adithya-chakravarthi-02/VENOTRACE_IoT_Dashboard/docs/images/dashboard_preview.jpg

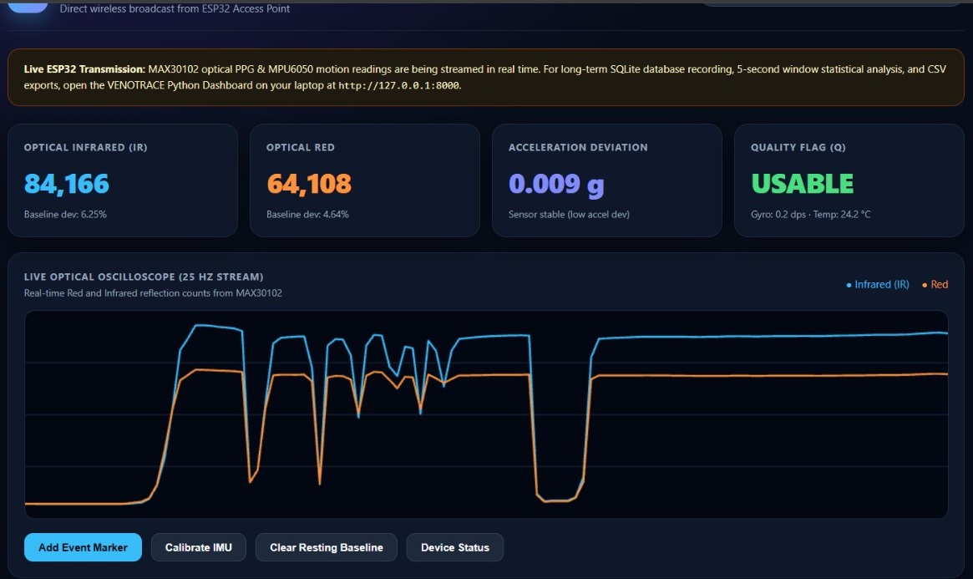
docs/images/dashboard_preview.jpg
