adithya-chakravarthi-02/VENOTRACE_IoT_Dashboard/docs/images/hardware_prototype.jpg

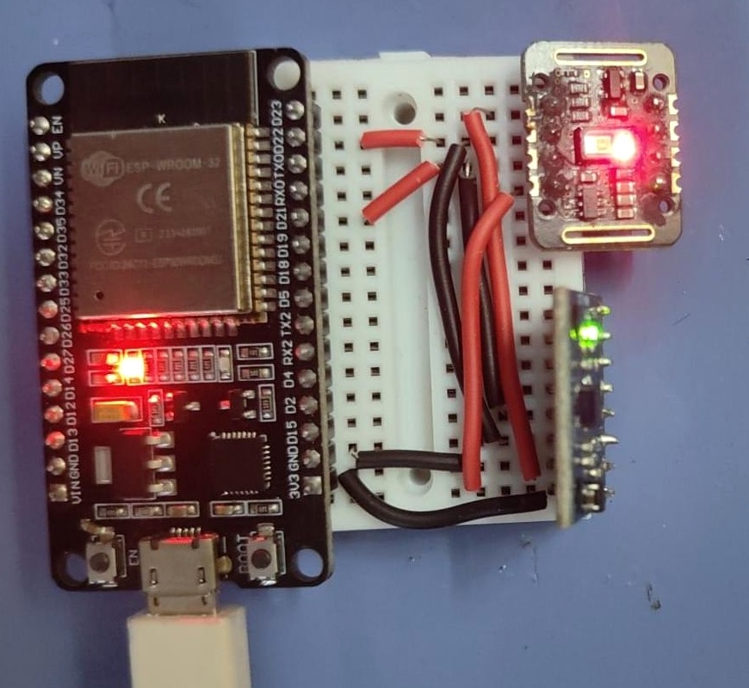
docs/images/hardware_prototype.jpg
