adithya-chakravarthi-02/VENOTRACE_IoT_Dashboard/docs/images/overview_block_diagram.png

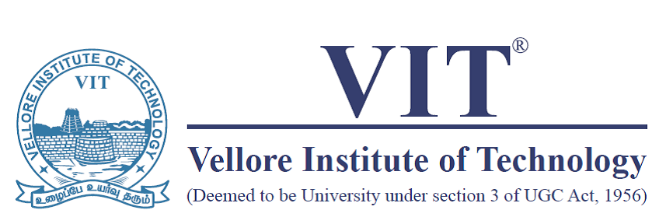
docs/images/overview_block_diagram.png
