adithya-chakravarthi-02/VENOTRACE_IoT_Dashboard/docs/images/measurement_protocol.png

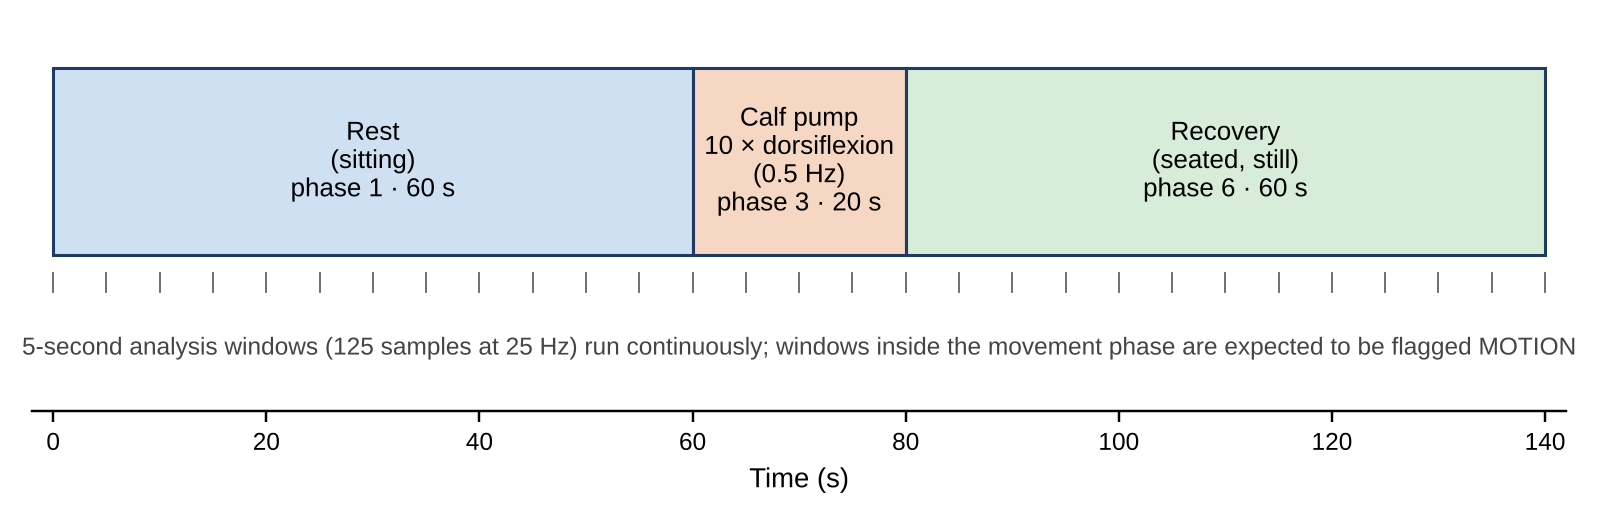
docs/images/measurement_protocol.png
