adithya-chakravarthi-02/VENOTRACE_IoT_Dashboard/(commit log)

2026-11-02 Initial commit: VENOTRACE IoT Dashboard and ESP32 Arduino firmware
2026-11-02 docs: remove emojis and insert document flowchart and architecture diagrams
